Ruben-Lohberg/One-Day-Hardware---Mini-Handheld/manufacturing/jlcpcb/BOM-mini_handheld.csv

Comment | Designator | Footprint | LCSC | Quantity
100 | R10,R11,R15 | R_0603_1608Metric | C22775 | 3
100k | R12 | R_0603_1608Metric | C25803 | 1
100n | C3,C5,C6,C7,C8 | C_0603_1608Metric | C14663 | 5
10k | R13,R14,R3,R4,R5,R6,R7 | R_0603_1608Metric | C25804 | 7
1k | R8,R9 | R_0603_1608Metric | C21190 | 2
1u | C9 | C_0603_1608Metric | C15849 | 1
2.2u | C1 | C_0603_1608Metric | C23630 | 1
4.7u | C2,C4 | C_0805_2012Metric | C1779 | 2
5.1k | R1,R2 | R_0603_1608Metric | C23186 | 2
AO3400A | Q1 | SOT-23 | C20917 | 1
FH12-12S-0.5SH(55) | J3 | Hirose_FH12-12S-0.5SH_1x12-1MP_P0.50mm_Horizontal | C88360 | 1
KT-0603R | D1,D2 | LED_0603_1608Metric | C2286 | 2
STM32G070CBT6 | U2 | LQFP-48_7x7mm_P0.5mm | C529338 | 1
TPS7A2430DBVR | U1 | SOT-23-5 | C2864435 | 1
TS-1088-AR02016 | SW1,SW2,SW3,SW4 | SW_SPST_TS-1088-xR020 | C720477 | 4
