Ruben-Lohberg/One-Day-Hardware---Mini-Handheld/mechanical/enclosure/tray.stl

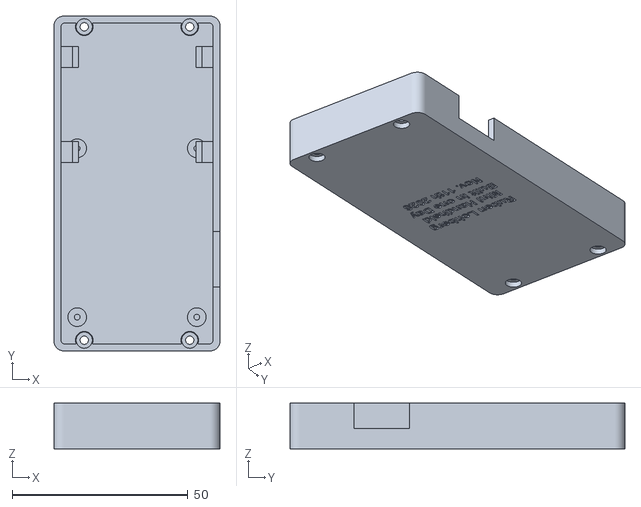
[picture p14: CAD file, 2026-11-12]
mechanical/enclosure/tray.stl
47.2 x 95.2 x 13.0
