Ruben-Lohberg/One-Day-Hardware---Mini-Handheld/mechanical/mini_handheld.step

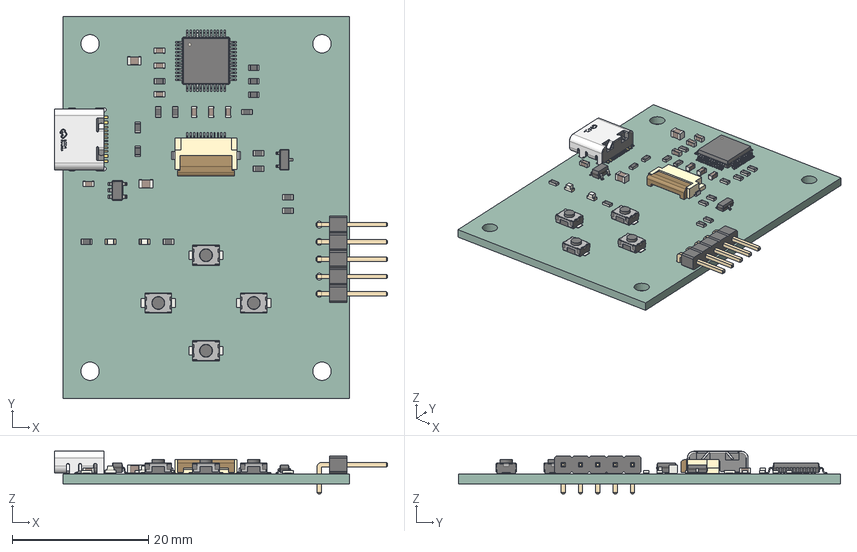
[picture p15: CAD file, 2026-11-12]
mechanical/mini_handheld.step
48.9 x 56.0 x 6.25 mm
R_0603_1608Metric x 15
C_0603_1608Metric x 7
SOT-23
SW_SPST_TS-1088-xR020 x 4
USB-C_SMD-TYPE-C-31-M-12
LED_0603_1608Metric x 2
SOT-23-5
C_0805_2012Metric x 2
PinHeader_1x05_P254mm_Horizontal
LQFP-48_7x7mm_P0.5mm
lock
pins
mini_handheld_PCB
