Ruben-Lohberg/One-Day-Hardware---Mini-Handheld/mechanical/display-fit.FCStd

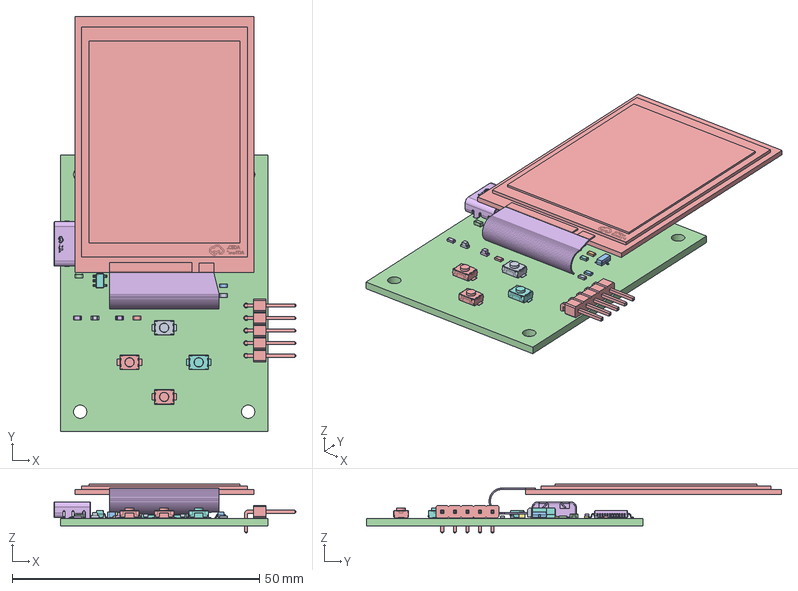
[picture p16: CAD file, 2026-11-12]
mechanical/display-fit.FCStd
48.9 x 84.0 x 9.84 mm
R_0603_1608Metric
R_0603_1608Metric002
R_0603_1608Metric004
R_0603_1608Metric006
R_0603_1608Metric008
C_0603_1608Metric
C_0603_1608Metric002
R_0603_1608Metric010
R_0603_1608Metric012
C_0603_1608Metric004
SOT-23
R_0603_1608Metric014
SW_SPST_TS-1088-xR020
USB-C_SMD-TYPE-C-31-M-12
USB-C_SMD-TYPE-C-31-M-001
USB-C_SMD-TYPE-C-31-M-002
USB-C_SMD-TYPE-C-31-M-003
USB-C_SMD-TYPE-C-31-M-004
USB-C_SMD-TYPE-C-31-M-005
USB-C_SMD-TYPE-C-31-M-006
USB-C_SMD-TYPE-C-31-M-007
USB-C_SMD-TYPE-C-31-M-008
USB-C_SMD-TYPE-C-31-M-009
USB-C_SMD-TYPE-C-31-M-010
USB-C_SMD-TYPE-C-31-M-011
USB-C_SMD-TYPE-C-31-M-012
USB-C_SMD-TYPE-C-31-M-013
R_0603_1608Metric016
R_0603_1608Metric018
LED_0603_1608Metric
R_0603_1608Metric020
SOT-23-5
LED_0603_1608Metric002
R_0603_1608Metric022
C_0805_2012Metric
C_0603_1608Metric006
SW_SPST_TS-1088-xR022
R_0603_1608Metric024
C_0805_2012Metric002
SW_SPST_TS-1088-xR024
SW_SPST_TS-1088-xR026
R_0603_1608Metric026
R_0603_1608Metric028
C_0603_1608Metric008
PinHeader_1x05_P254mm_Horizontal
LQFP-48_7x7mm_P0.5mm
C_0603_1608Metric010
lock
pins
C_0603_1608Metric012
mini_handheld_PCB
HS20HS072RX display (supplier geometry)
FPC fit envelope — R2.5, 2.95 mm inserted
