Ruben-Lohberg/One-Day-Hardware---Mini-Handheld/mechanical/enclosure/bezel.stl

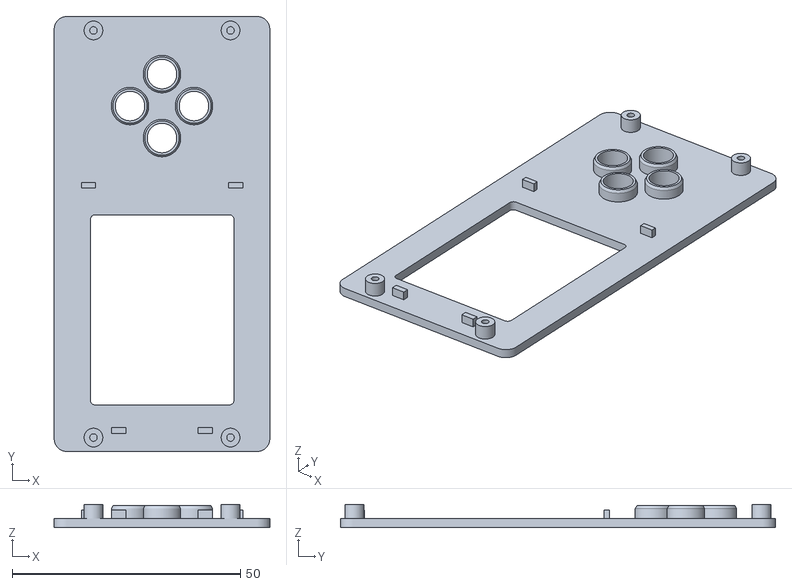
[picture p17: CAD file, 2026-11-12]
mechanical/enclosure/bezel.stl
47.2 x 95.2 x 5.10
