Ruben-Lohberg/One-Day-Hardware---Mini-Handheld/mechanical/enclosure/two-cases-plate.stl

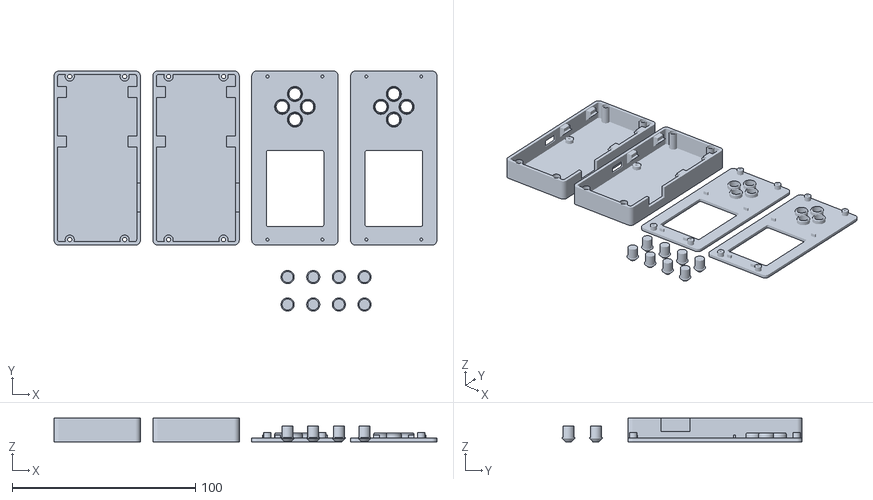
[picture p18: CAD file, 2026-11-12]
mechanical/enclosure/two-cases-plate.stl
209.2 x 131.2 x 13.0
