Ruben-Lohberg/One-Day-Hardware---Mini-Handheld/mechanical/HS20HS072RX-flat.step

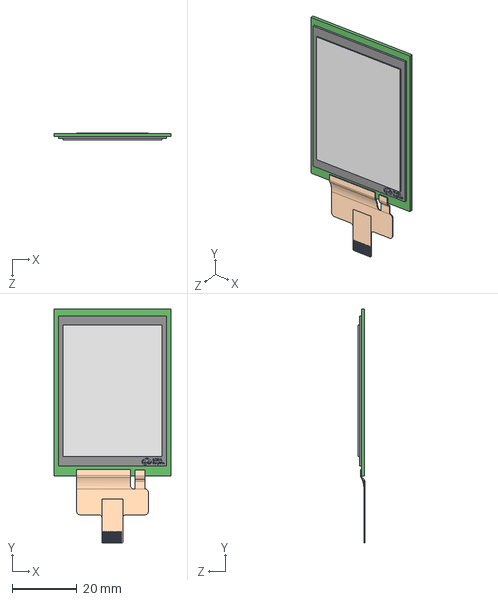
[picture p19: CAD file, 2026-11-12]
mechanical/HS20HS072RX-flat.step
36.2 x 72.6 x 2.11 mm
