Ruben-Lohberg/One-Day-Hardware---Mini-Handheld/mechanical/enclosure/plunger.stl

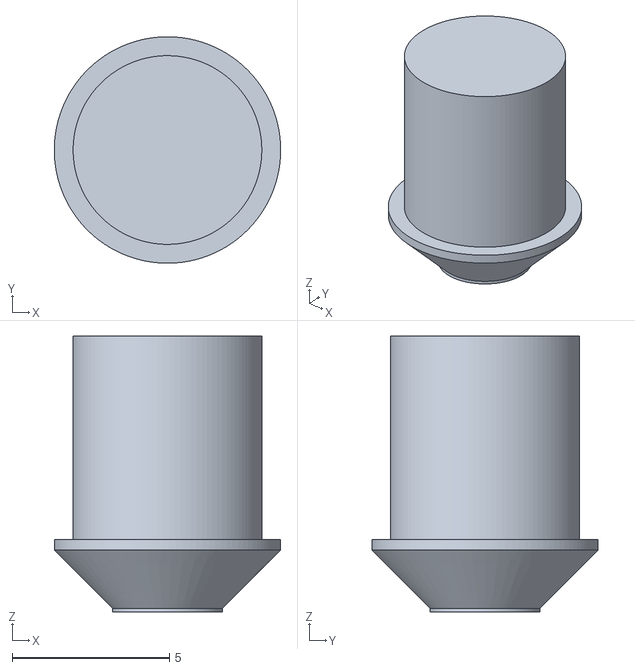
[picture p20: CAD file, 2026-11-12]
mechanical/enclosure/plunger.stl
7.20 x 7.20 x 8.77
