Ruben-Lohberg/One-Day-Hardware---Mini-Handheld/mechanical/enclosure/case-and-board-plate.stl

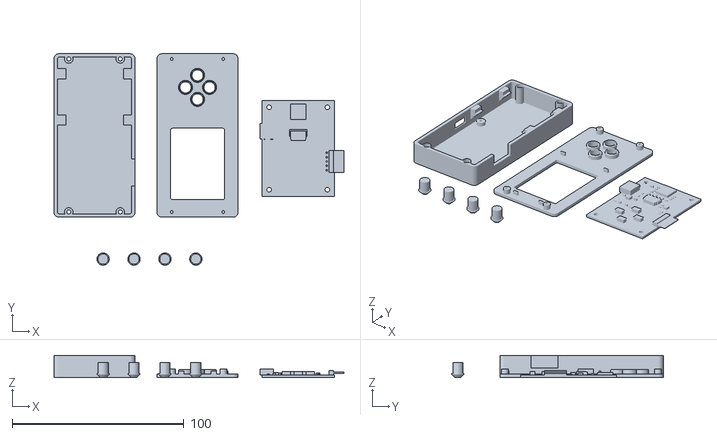
[picture p21: CAD file, 2026-11-12]
mechanical/enclosure/case-and-board-plate.stl
168.9 x 123.2 x 13.0
