Ruben-Lohberg/One-Day-Hardware---Mini-Handheld/mechanical/enclosure/pcb-fit-gauge.stl

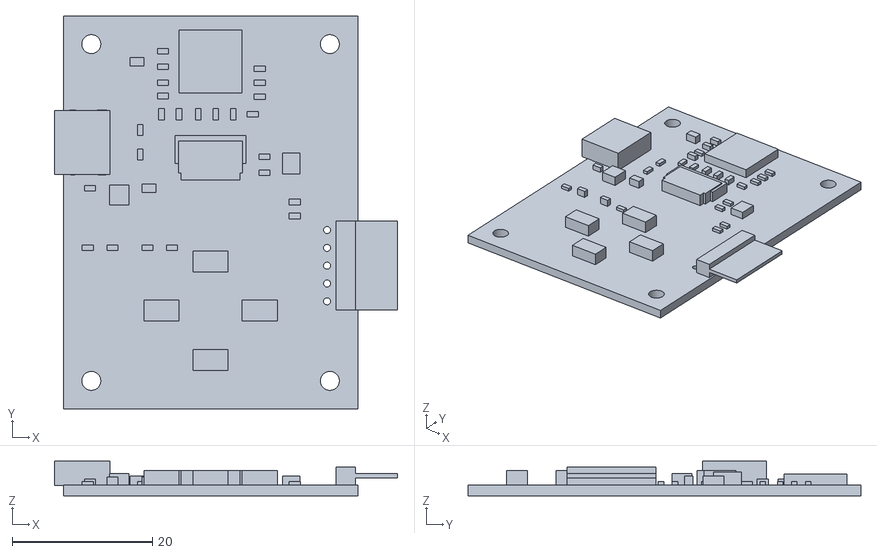
[picture p22: CAD file, 2026-11-12]
mechanical/enclosure/pcb-fit-gauge.stl
48.9 x 56.0 x 4.93
