Ruben-Lohberg/One-Day-Hardware---Mini-Handheld/mechanical/enclosure/enclosure.FCStd

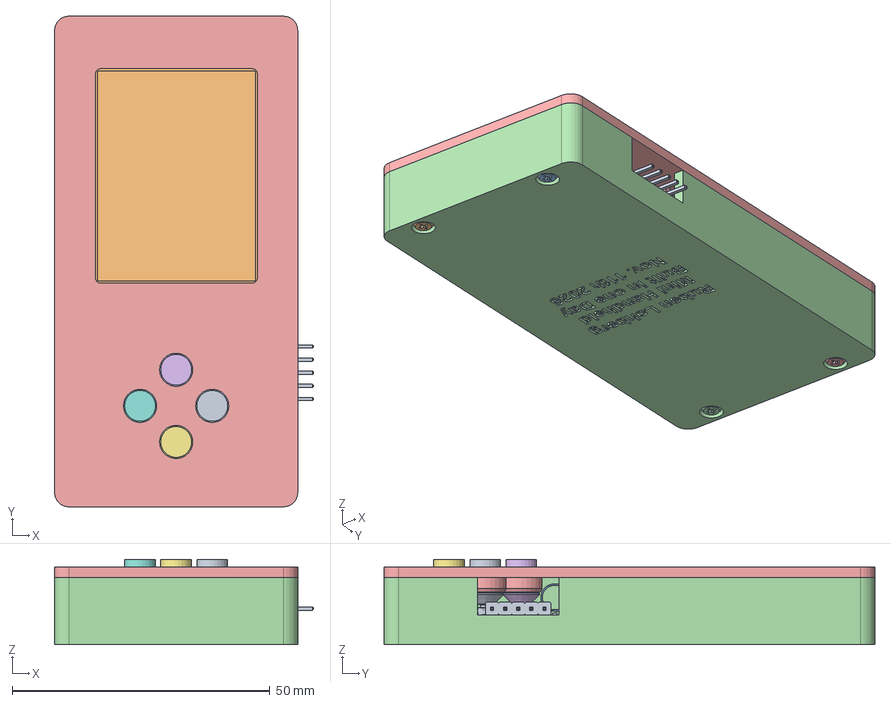
[picture p23: CAD file, 2026-11-12]
mechanical/enclosure/enclosure.FCStd
50.2 x 95.2 x 16.5 mm
Populated PCB
LCD
Folded FPC
Lower tray
Top bezel
Up plunger
Down plunger
Left plunger
Right plunger
M2 x 12 case screw 1
M2 x 12 case screw 2
M2 x 12 case screw 3
M2 x 12 case screw 4
M2 x 5 PCB screw 1
M2 x 5 PCB screw 2
M2 x 5 PCB screw 3
M2 x 5 PCB screw 4
