Ruben-Lohberg/One-Day-Hardware---Mini-Handheld/mini_handheld/3dmodels/C165948.step

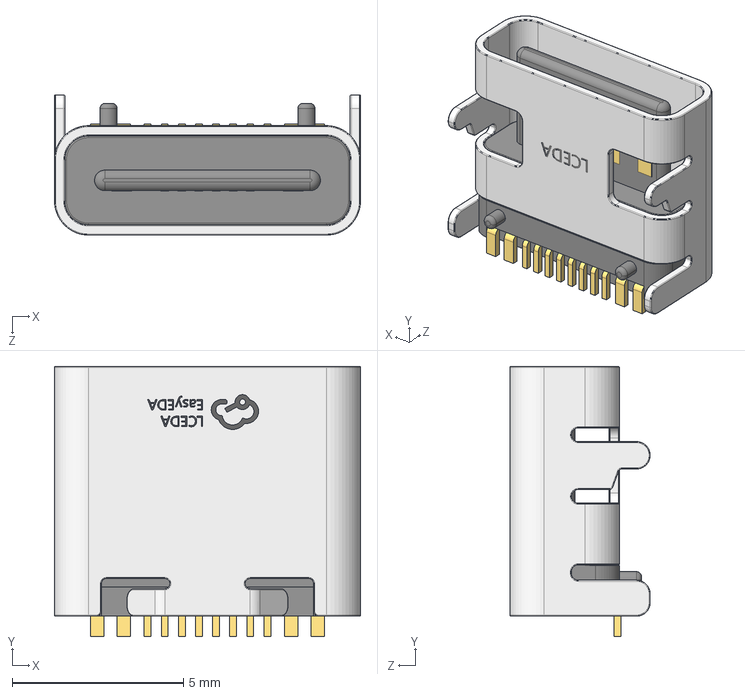
[picture p24: CAD file, 2026-11-12]
mini_handheld/3dmodels/C165948.step
8.94 x 7.90 x 4.10 mm
