Ruben-Lohberg/One-Day-Hardware---Mini-Handheld/mini_handheld/3dmodels/C5160788.step

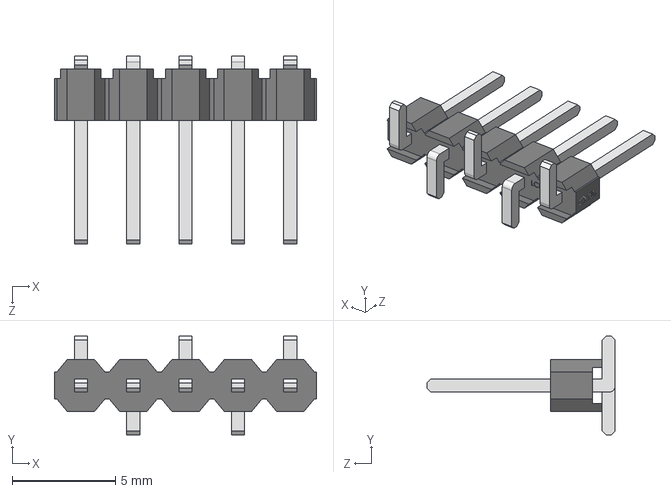
[picture p25: CAD file, 2026-11-12]
mini_handheld/3dmodels/C5160788.step
12.7 x 4.80 x 9.14 mm
