Ruben-Lohberg/One-Day-Hardware---Mini-Handheld/mini_handheld/mini_handheld.kicad_pcb

## KiCad design mini_handheld/mini_handheld.kicad_pcb (2026-11-12)

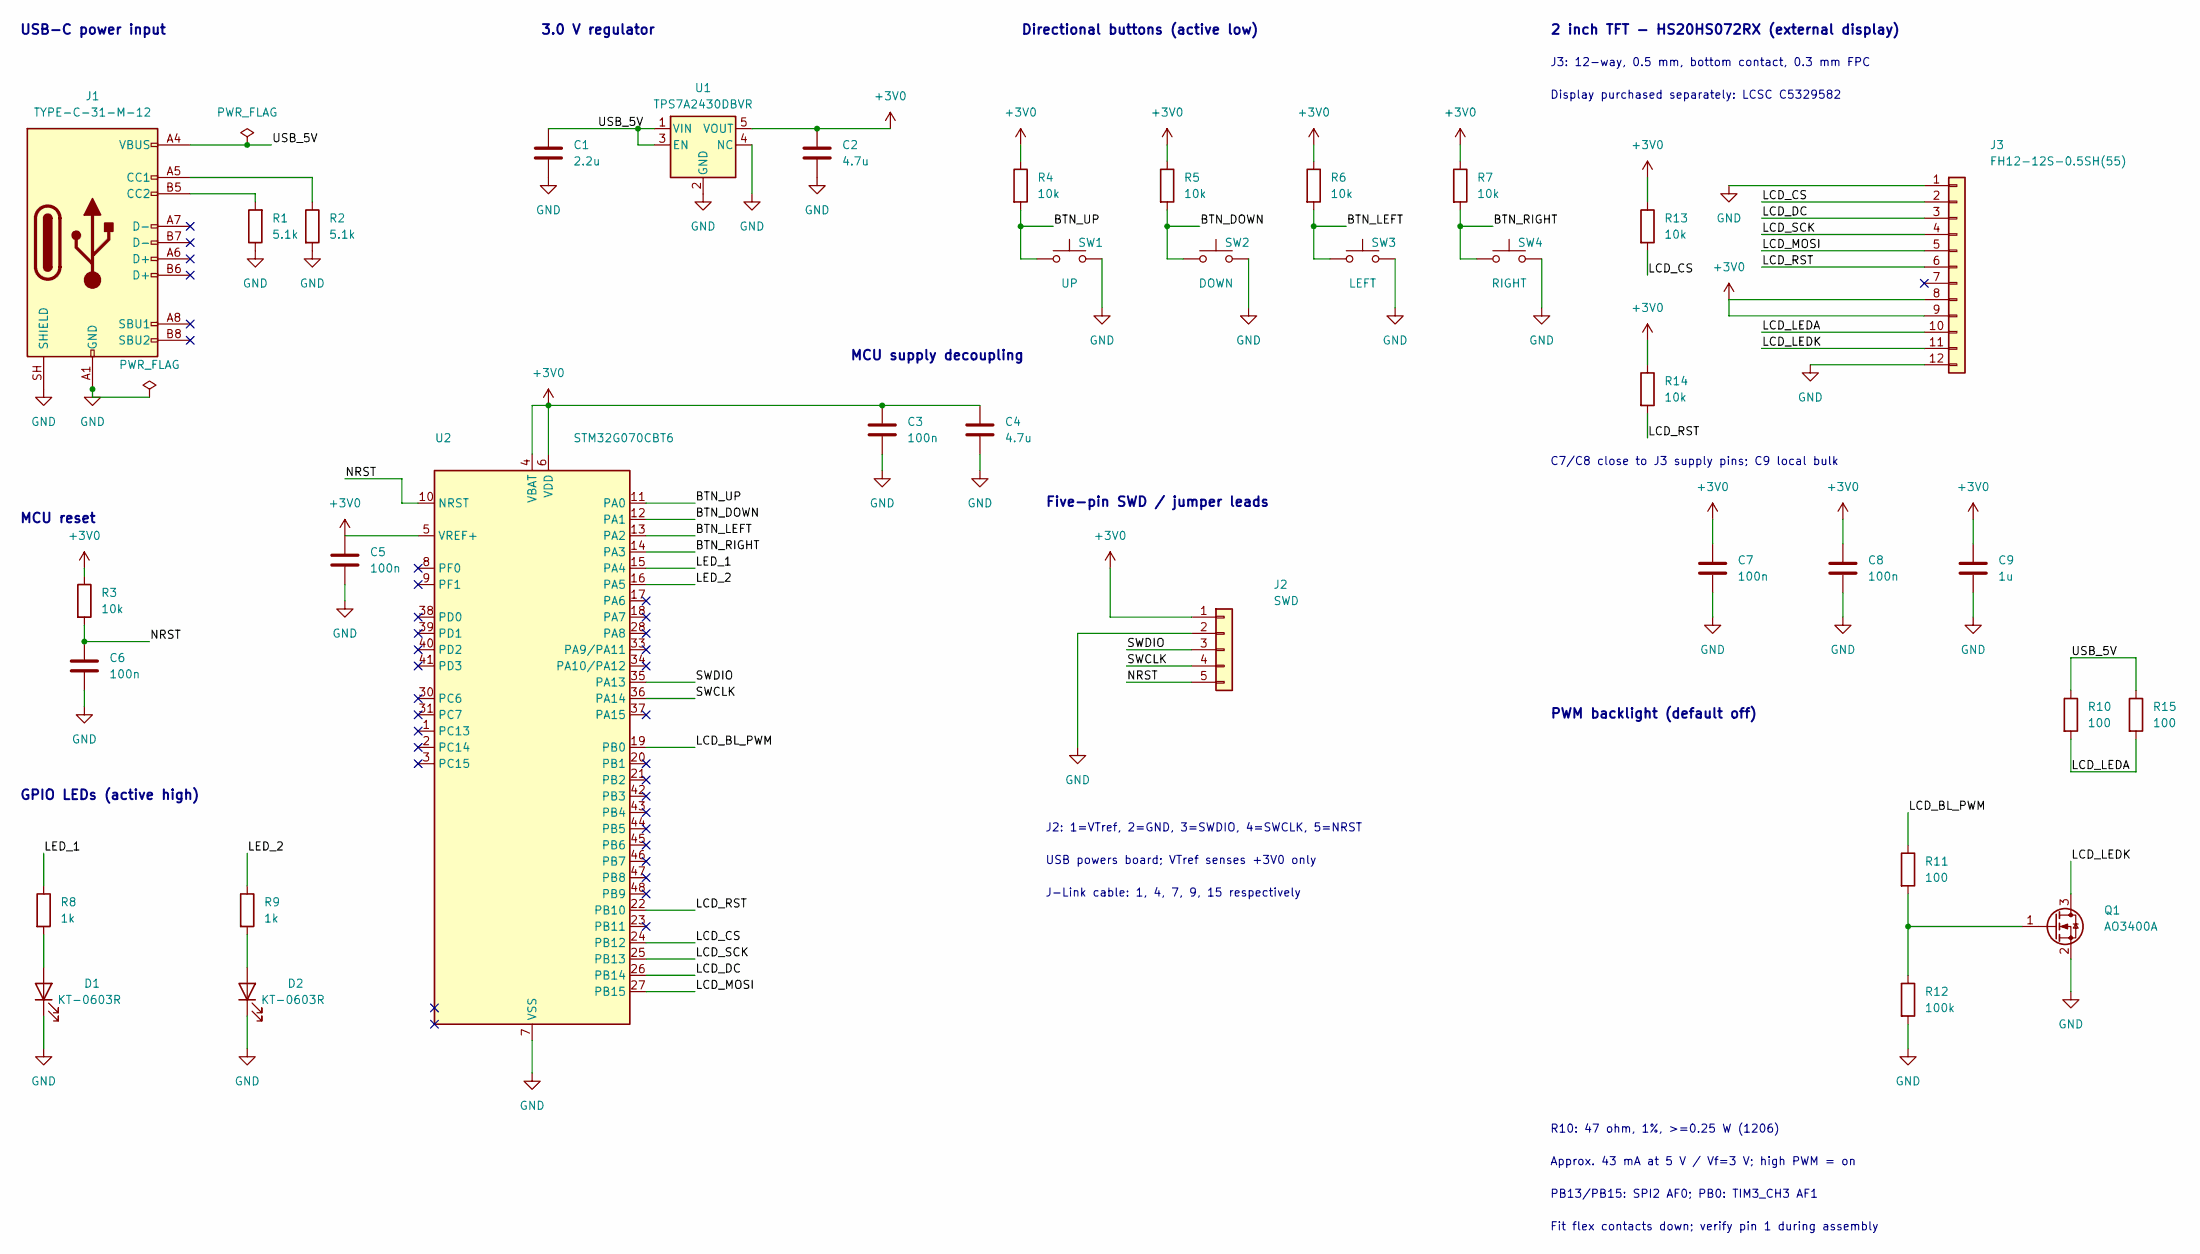
[picture p26: schematic mini_handheld.kicad_sch]

Parts:
C1: 2.2u; C_0603_1608Metric; Tolerance 10%; Voltage 50V; MPN CL10A225KO8NNNC; LCSC C23630
C2, C4: 4.7u; C_0805_2012Metric; Tolerance 10%; Voltage 25V; MPN CL21A475KAQNNNE; LCSC C1779
C3, C5, C6, C7, C8: 100n; C_0603_1608Metric; Tolerance 10%; Voltage 50V; MPN CC0603KRX7R9BB104; LCSC C14663
C9: 1u; C_0603_1608Metric; Tolerance 10%; Voltage 50V; MPN CL10A105KB8NNNC; LCSC C15849
D1, D2: KT-0603R; LED_0603_1608Metric; MPN KT-0603R; LCSC C2286
J1: TYPE-C-31-M-12; USB_C_Receptacle_HRO_TYPE-C-31-M-12_Edge; MPN TYPE-C-31-M-12; LCSC C165948
J2: SWD; PinHeader_1x05_P2.54mm_Horizontal_Edge
J3: FH12-12S-0.5SH(55); Hirose_FH12-12S-0.5SH_1x12-1MP_P0.50mm_Horizontal; MPN FH12-12S-0.5SH(55); LCSC C88360
Q1: AO3400A; SOT-23; MPN AO3400A; LCSC C20917
R1, R2: 5.1k; R_0603_1608Metric; Tolerance 1%; Voltage 75V; MPN 0603WAF5101T5E; LCSC C23186
R3, R4, R5, R6, R7, R13, R14: 10k; R_0603_1608Metric; Tolerance 1%; Voltage 75V; MPN 0603WAF1002T5E; LCSC C25804
R8, R9: 1k; R_0603_1608Metric; Tolerance 1%; Voltage 75V; MPN 0603WAF1001T5E; LCSC C21190
R10, R11, R15: 100; R_0603_1608Metric; Tolerance 1%; Voltage 75V; MPN 0603WAF1000T5E; LCSC C22775
R12: 100k; R_0603_1608Metric; Tolerance 1%; Voltage 75V; MPN 0603WAF1003T5E; LCSC C25803
SW1: UP; SW_SPST_TS-1088-xR020; MPN TS-1088-AR02016; LCSC C720477
SW2: DOWN; SW_SPST_TS-1088-xR020; MPN TS-1088-AR02016; LCSC C720477
SW3: LEFT; SW_SPST_TS-1088-xR020; MPN TS-1088-AR02016; LCSC C720477
SW4: RIGHT; SW_SPST_TS-1088-xR020; MPN TS-1088-AR02016; LCSC C720477
U1: TPS7A2430DBVR; SOT-23-5; MPN TPS7A2430DBVR; LCSC C2864435
U2: STM32G070CBT6; LQFP-48_7x7mm_P0.5mm; MPN STM32G070CBT6; LCSC C529338

Connections:
+3V0: C2.1, C3.1, C4.1, C5.1, C7.1, C8.1, C9.1, J2.1, J3.8, J3.9, R3.1, R4.1, R5.1, R6.1, R7.1, R13.1, R14.1, U1.5 (VOUT), U2.4 (VBAT), U2.5 (VREF+), U2.6 (VDD)
/BTN_DOWN: R5.2, SW2.1, U2.12 (PA1)
/BTN_LEFT: R6.2, SW3.1, U2.13 (PA2)
/BTN_RIGHT: R7.2, SW4.1, U2.14 (PA3)
/BTN_UP: R4.2, SW1.1, U2.11 (PA0)
/LCD_BL_PWM: R11.1, U2.19 (PB0)
/LCD_CS: J3.2, R13.2, U2.24 (PB12)
/LCD_DC: J3.3, U2.26 (PB14)
/LCD_LEDA: J3.10, R10.2, R15.2
/LCD_LEDK: J3.11, Q1.3 (D)
/LCD_MOSI: J3.5, U2.27 (PB15)
/LCD_RST: J3.6, R14.2, U2.22 (PB10)
/LCD_SCK: J3.4, U2.25 (PB13)
/LED_1: R8.1, U2.15 (PA4)
/LED_2: R9.1, U2.16 (PA5)
/NRST: C6.1, J2.5, R3.2, U2.10 (NRST)
/SWCLK: J2.4, U2.36 (PA14)
/SWDIO: J2.3, U2.35 (PA13)
/USB_5V: C1.1, J1.A4 (VBUS), J1.A9 (VBUS), J1.B4 (VBUS), J1.B9 (VBUS), R10.1, R15.1, U1.1 (VIN), U1.3 (EN)
GND: C1.2, C2.2, C3.2, C4.2, C5.2, C6.2, C7.2, C8.2, C9.2, D1.1 (K), D2.1 (K), J1.A1 (GND), J1.A12 (GND), J1.B1 (GND), J1.B12 (GND), J1.SH (SHIELD), J2.2, J3.1, J3.12, Q1.2 (S), R1.1, R2.2, R12.2, SW1.2, SW2.2, SW3.2, SW4.2, U1.2 (GND), U1.4 (NC), U2.7 (VSS)
unnamed: D1.2 (A), R8.2
unnamed: D2.2 (A), R9.2
unnamed: J1.A5 (CC1), R2.1
unnamed: J1.B5 (CC2), R1.2
unnamed: Q1.1 (G), R11.2, R12.1

Notes on the sheet:
3.0 V regulator
Fit flex contacts down; verify pin 1 during assembly
GPIO LEDs (active high)
J2: 1=VTref, 2=GND, 3=SWDIO, 4=SWCLK, 5=NRST
Display purchased separately: LCSC C5329582
PWM backlight (default off)
MCU reset
MCU supply decoupling
J-Link cable: 1, 4, 7, 9, 15 respectively
Approx. 43 mA at 5 V / Vf=3 V; high PWM = on
PB13/PB15: SPI2 AF0; PB0: TIM3_CH3 AF1
Five-pin SWD / jumper leads
J3: 12-way, 0.5 mm, bottom contact, 0.3 mm FPC
USB-C power input
2 inch TFT - HS20HS072RX (external display)
Directional buttons (active low)
C7/C8 close to J3 supply pins; C9 local bulk
R10: 47 ohm, 1%, >=0.25 W (1206)
USB powers board; VTref senses +3V0 only

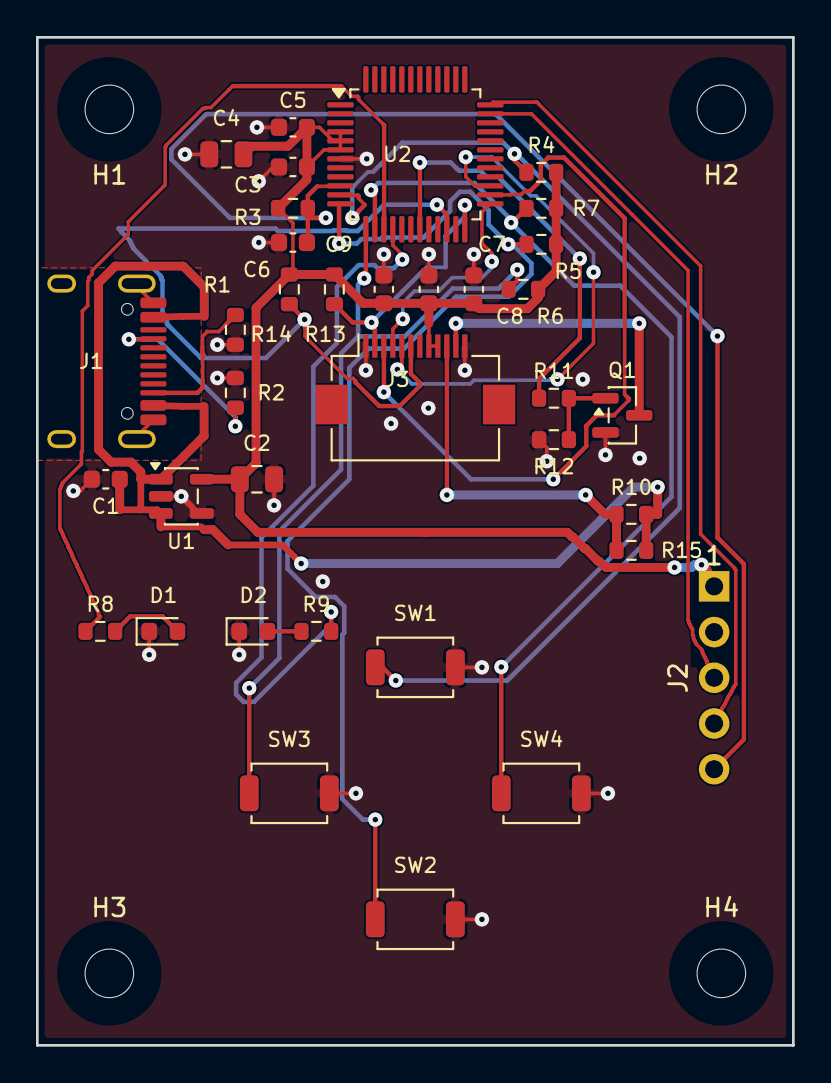
[picture p27: board mini_handheld.kicad_pcb from above]

Board: 2 copper layers, 42.0 x 56.0 mm, 40 parts (0 on the bottom side), 25 nets.

Other parts of the board:
H1, H2, H3, H4: MountingHole_2.7mm_M2.5
