Ruben-Lohberg/One-Day-Hardware---Mini-Handheld/(commit log)

2026-11-12 Start with USB-C power in KiCad
    I started with a small USB-powered handheld in mind. The first schematic
    gets 5 V from USB-C and uses a 3.3 V regulator.
    Codex GPT-6.1 sol: Replayed the original power-circuit commit for the build history.
    [mini_handheld.kicad_pcb, mini_handheld.kicad_sch]
2026-11-12 Give the STM32 power, reset and a debug header
    Before adding the fun stuff, give the STM32 local bypass capacitors,
    a reset circuit and a way to flash it with the J-Link.
    Codex GPT-6.1 sol: Recovered the matching schematic save and checked which blocks it contains.
    [mini_handheld.kicad_sch]
2026-11-12 Wire the four direction buttons
    Use four active-low switches with pull-ups so I can read the D-pad
    directly from GPIO.
    Codex GPT-6.1 sol: Isolated the saved D-pad milestone from KiCad's local history.
    [mini_handheld.kicad_sch]
2026-11-12 Add the TFT, backlight and indicator LEDs
    Bring out SPI and backlight PWM to the display flex socket, add two
    indicator LEDs and swap the large debug connector for five pins.
    Codex GPT-6.1 sol: Helped check pin assignments and recover the saved schematic revision.
    [C5160788.step, mini_handheld.kicad_sch]
2026-11-12 Lay out the parts on the first board outline
    The first placement fits inside 60 x 95 mm. This lets me see where
    the buttons, display and connector openings need to go.
    Codex GPT-6.1 sol: Recovered the original placement snapshot before the board was shrunk.
    [mini_handheld.kicad_pcb]
2026-11-12 Shrink the PCB and route both copper layers
    Let the enclosure carry the screen and shrink the board to 42 x 56 mm.
    Keep the display clock short and give the SWD traces room. Set the logic
    rail to 3.0 V and switch to the through-hole SWD header.
    Codex GPT-6.1 sol: Helped compare routes and rerun ERC, DRC and schematic parity.
    [C165948.step, mini_handheld.kicad_pcb, mini_handheld.kicad_sch]
2026-11-12 Simulate USB droop and the TFT clock edge
    Put the load steps, cable impedance and display clock assumptions in
    separate SPICE decks so I can see which numbers move.
    Codex GPT-6.1 sol: Helped build the decks, run ngspice and plot the rail transient.
2026-11-12 Test the buttons and LEDs in Renode
    Build a small Cortex-M0+ ELF and use it to check the idle and pressed
    states before putting a display driver on top.
    Codex GPT-6.1 sol: Helped wire up the virtual GPIO and verify all four inputs.
2026-11-12 Get Snake running on the virtual TFT
    Send the display commands and pixels over SPI2. Use a browser D-pad
    to exercise the display diagnostic and play Snake before the board arrives.
    Codex GPT-6.1 sol: Helped implement the panel model and run the display, game and SPI checks.
2026-11-12 Fit the display and folded flex around the PCB
    Export the populated board from KiCad and bring it into FreeCAD.
    Model the tail folding back into the socket to see what clears.
    Codex GPT-6.1 sol: Helped script the STEP handoff and check the nominal flex geometry.
    [HS20HS072RX-flat.step, display-fit.FCStd, mini_handheld.step]
2026-11-12 Make a printable case and a PCB fit gauge
    Split the shell into a tray and bezel. Give the screen its own ledges
    and leave room for four loose plungers. Put a PCB fit gauge on the plate.
    Codex GPT-6.1 sol: Helped script the FreeCAD solids and check the regenerated parts and plate.
    [bezel.stl, case-and-board-plate.stl, enclosure.FCStd, pcb-fit-gauge.stl, plunger.stl, tray.stl, two-cases-plate.stl]
2026-11-12 Pack the fabrication files for the first order
    Keep the fabrication ZIP, BOM and placements together. Leave USB-C
    and SWD for hand soldering and buy the display separately.
    Codex GPT-6.1 sol: Helped review part costs, assembly rotations and BOM/placement parity.
    [BOM-mini_handheld.csv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]
2026-11-12 Write up the mini handheld build
    Walk through the decisions in order with a schematic, board renders,
    a simulation plot, the virtual handheld and the case. Leave the bench
    checks and photos for when the first parts come in.
    Codex GPT-6.1 sol: Helped capture the tools in use, check the links and organize the notes.
2026-11-13 Show the first printed fit prototype
    Add photos from the build plate through to the closed case. Codex GPT-6.1 sol prepared the photos and helped write the captions.
2026-11-13 Put the Snake demo on GitHub Pages
    Build the timing mock from the same C source on every relevant push. Keep quick D-pad taps visible to the game even when the modeled SPI write delays polling. Codex GPT-6.1 sol helped package and test the browser demo.
2026-11-13 Use the first Clang on PATH
    The Ubuntu runner lists Clang under both /usr/bin and /bin. Codex GPT-6.1 sol traced the failure to PowerShell returning both paths.
2026-11-13 Organize the handheld build into eight chapters
    Start with the MCU and display choices, then follow the board, firmware, case, order, and print. Codex GPT-6.1 sol helped organize the chapters and verify the part specs.
2026-11-13 Polish the build notes and photos
    Show the copper layers separately, explain the rainbow border, and add a full-board view with a close-up of the display flex. Tighten the print photos and turn the open-case view upright.
    Codex GPT-6.1 sol helped edit the README and prepare the images.
2026-11-13 Keep the showcase focused on the build
    Keep the demo, build photos, and instructions for running, printing, and ordering. Move the plugin database out of version control and use portable tool paths. Codex GPT-6.1 sol helped trim the notes and verify the remaining build steps.
